mvvproject/DivGMX/divgmx_sound/readme.txt

Sound
Конфигурация высокопроизводительной звуковой карты для spectrum-совместимых компьютеров с шиной ZX-BUS.

После подключения станут доступны такие устройства как:
1. Beeper (стандартный аудио выход)
2. General Sound 512К
3. SounDrive v1.05
4. Turbo Sound - 2x YM2149
5. Tutbo Sound Easy - 2x YM2149 + SAA1099 (12 стерео каналов)
6. Видео-страницы 5 и 7 (порт 7FFD) выводятся на HDMI 640x480@60Hz
