mvvproject/DivGMX/divgmx_spec256/readme.md

#### SPEC256
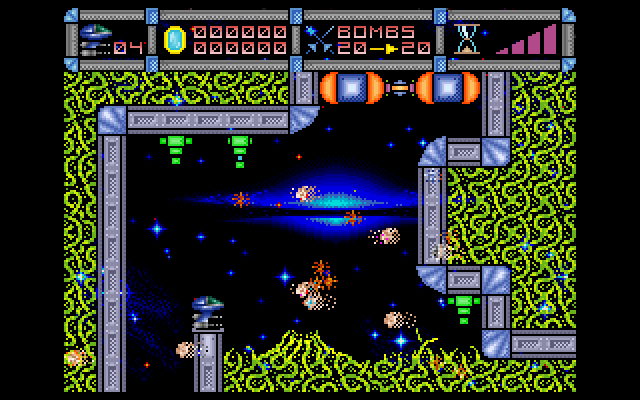
[picture p2: divgmx_spec256/pic1.png]
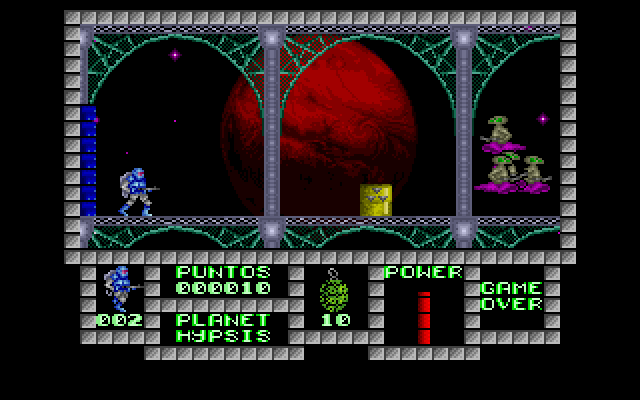
[picture p3: divgmx_spec256/pic2.png]
 

SPEC256: http://www.emulatronia.com/emusdaqui/spec256/download-eng.htm

игры: http://www.emulatronia.com/emusdaqui/spec256/download-eng.htm

редактор: http://kolmck.ru/apps/EmuZ/EmuZWin_Eng.htm

Демонстрационное видео:

Spec256 on FPGA (ReVerSE-U16) (http://www.youtube.com/watch?feature=player_embedded&v=0wNCMqNwaIU)

ReVerSE-U16 FPGA SoftCore - Spec256 (build 20170604) (https://www.youtube.com/watch?v=5JCH4aDUbvE)

build 20171030:
- Реализован фон F6 = Layer on/off

build 20171028:
- CPU: T80_GFX @ 3.5MHz
- RAM: 48K
- ROM: 16K ('82)
- VGA: 256x192 GFX256/Std (ZX Spectrum 48K)
- HDMI: 576P @ 49Hz
- Sound: Port 0xFE (Beeper)
- F1 Joystick on/off
- F2 = режим 256c
- F5 = MENU для загрузки игр
- Joystick: Kempston, Gamepad (Defender Game Master G2)
- Games: Abu Simbel, Army Moves, Army Moves 2, Cybernoid, Game Over, Game Over 2, JetPac, Knight Lore, Phantis, Sabre Wulf, Scooby Doo, Solomon's Key, Underwurlde
