mvvproject/DivGMX/divgmx_board/images/box.jpg

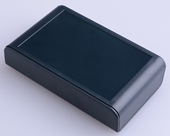
divgmx_board/images/box.jpg
