mvvproject/DivGMX/divgmx_board/images/connectors.jpg

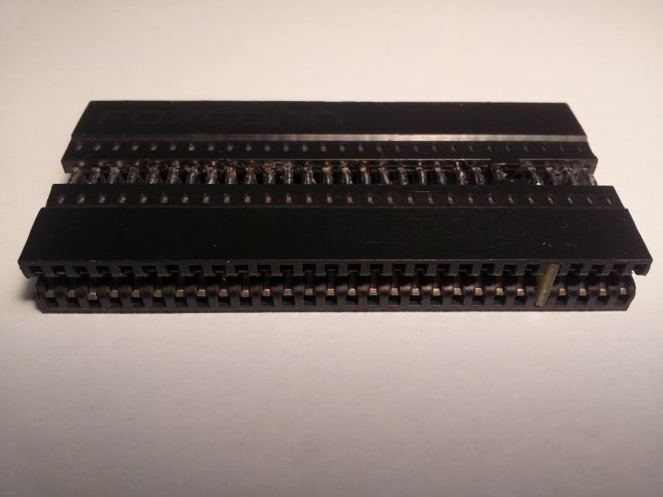
divgmx_board/images/connectors.jpg
