mvvproject/DivGMX/divgmx_board/images/divgmx_brd_eagle.png

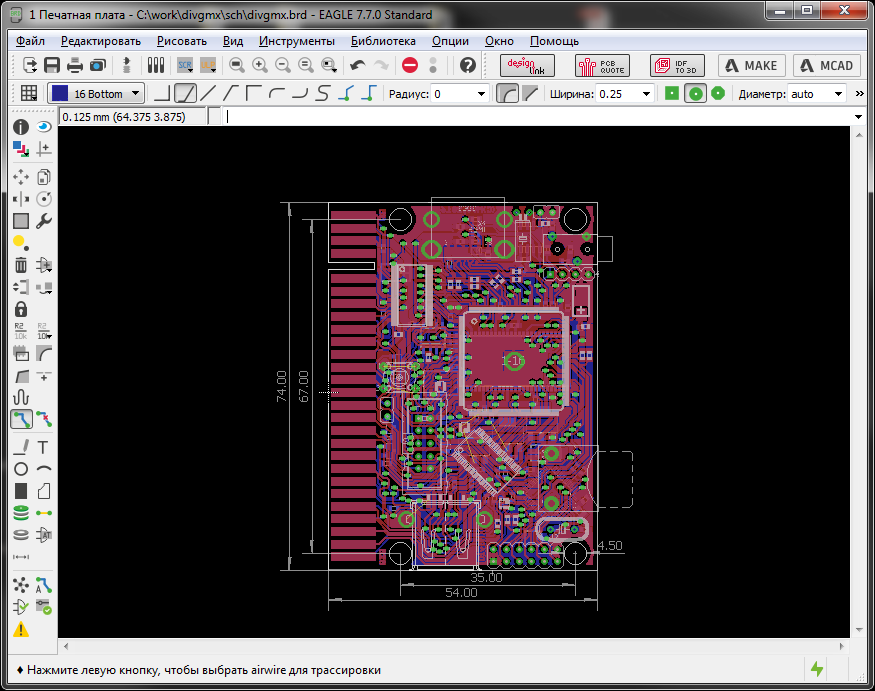
divgmx_board/images/divgmx_brd_eagle.png
