mvvproject/DivGMX/divgmx_board/images/divgmx_spectrum48k.jpg

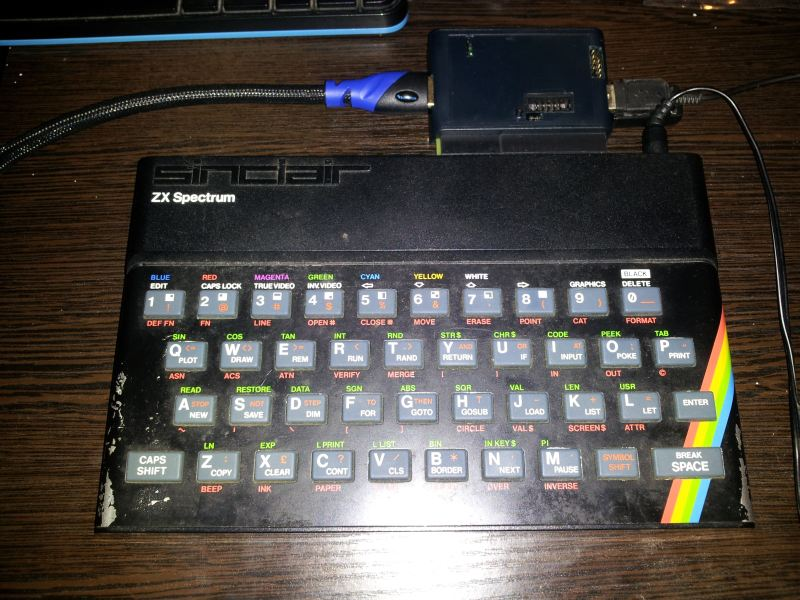
divgmx_board/images/divgmx_spectrum48k.jpg
