mvvproject/DivGMX/divgmx_board/images/divgmx_zx_spectrum+3.jpg

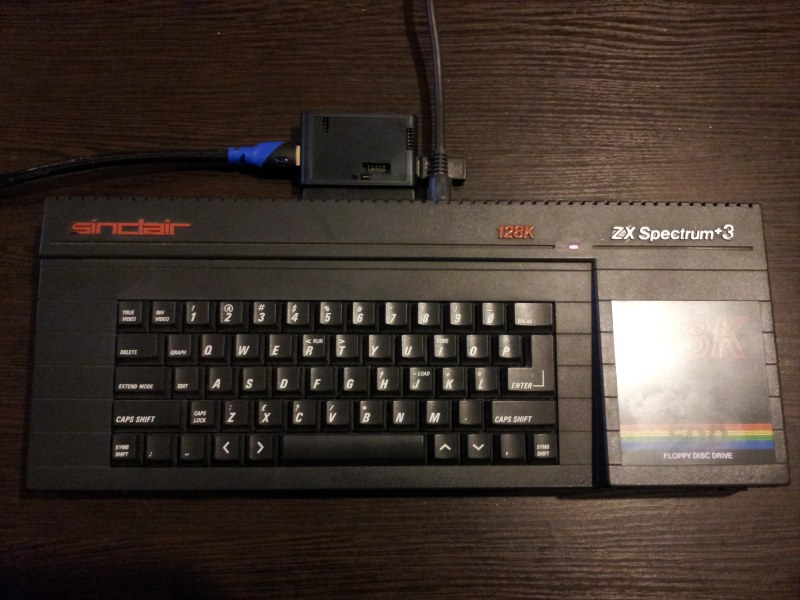
divgmx_board/images/divgmx_zx_spectrum+3.jpg
