mvvproject/DivGMX/divgmx_test_board/readme.txt

HDT (Hardware Diagnostic Tests)
Тест платы DivGMX

Для теста интерфейса, подключите Extender Tester к плате DivGMX, нажимая на кнопку "NMI" на плате DivGMX наблюдайте аналогичное включение светодиодов как в поле Extender.

20170907:
добавлены тесты 05h-29h бегущая единица

20170917:
тесты SDRAM патернами AAh, 55h, 00h, FFh
