mvvproject/DivGMX/divgmx_board/images/divgmx_pxoenix_test.jpg

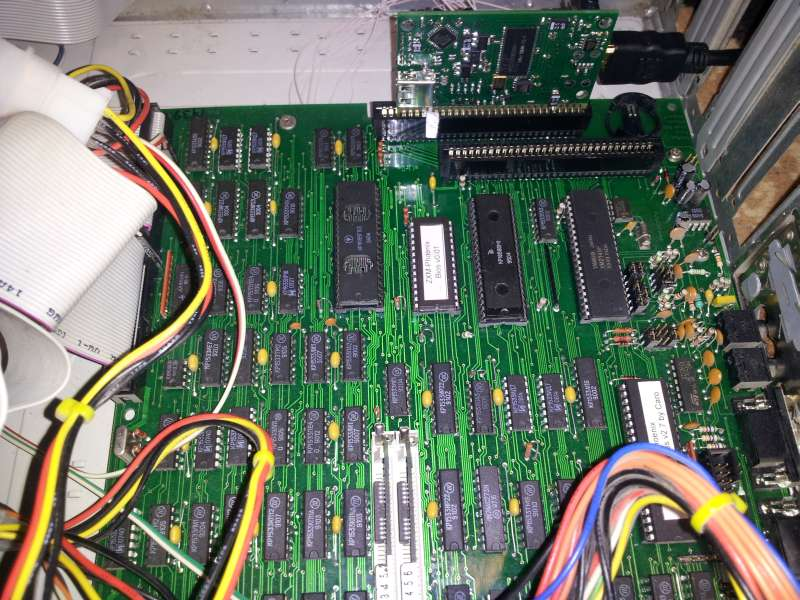
divgmx_board/images/divgmx_pxoenix_test.jpg
