mvvproject/DivGMX/divgmx_test_board/divgmx_extender_tester/DivGMX_extender_tester.jpg

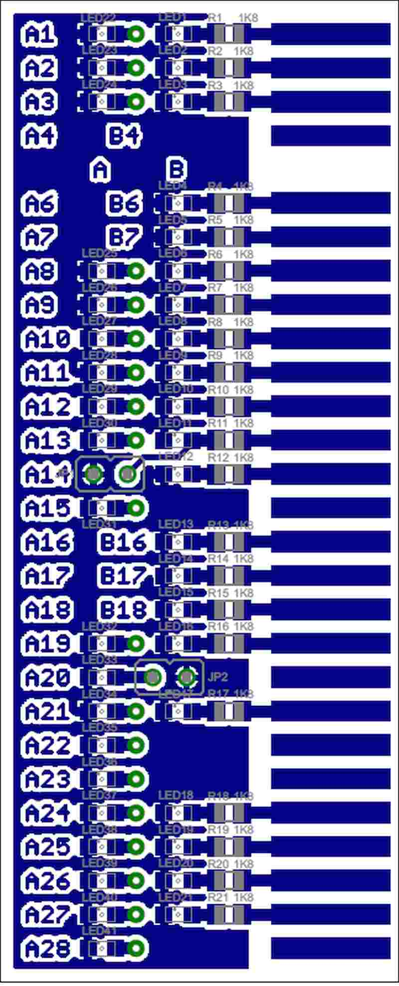
divgmx_test_board/divgmx_extender_tester/DivGMX_extender_tester.jpg
