mvvproject/DivGMX/(threads)

Thread 1 (2020-03-28):

Any boards for sale?

gazsp, 2020-03-28:
Hi there. Are you offering to sell fully assembled boards? Can I email you for more details?

Cheers,
Gaz.

semack, 2020-06-03:
Hi,

The same question, especially in Ukraine ;)

BR,
Andriy.

Thread 2 (2020-06-03):

Harlequin 128 2D question

semack, 2020-06-03:
Доброго здоровья,

Был ли опыт использования с Harlequin 128 2D?
Есть ли возможность приобрести плату?

Я так понял Вы в Черкассах, я из Кременчуга.

С уважением,
Андрей.
