mvvproject/DivGMX/divgmx_test_board/divgmx_extender_tester/divgmx_extender_tester.pdf

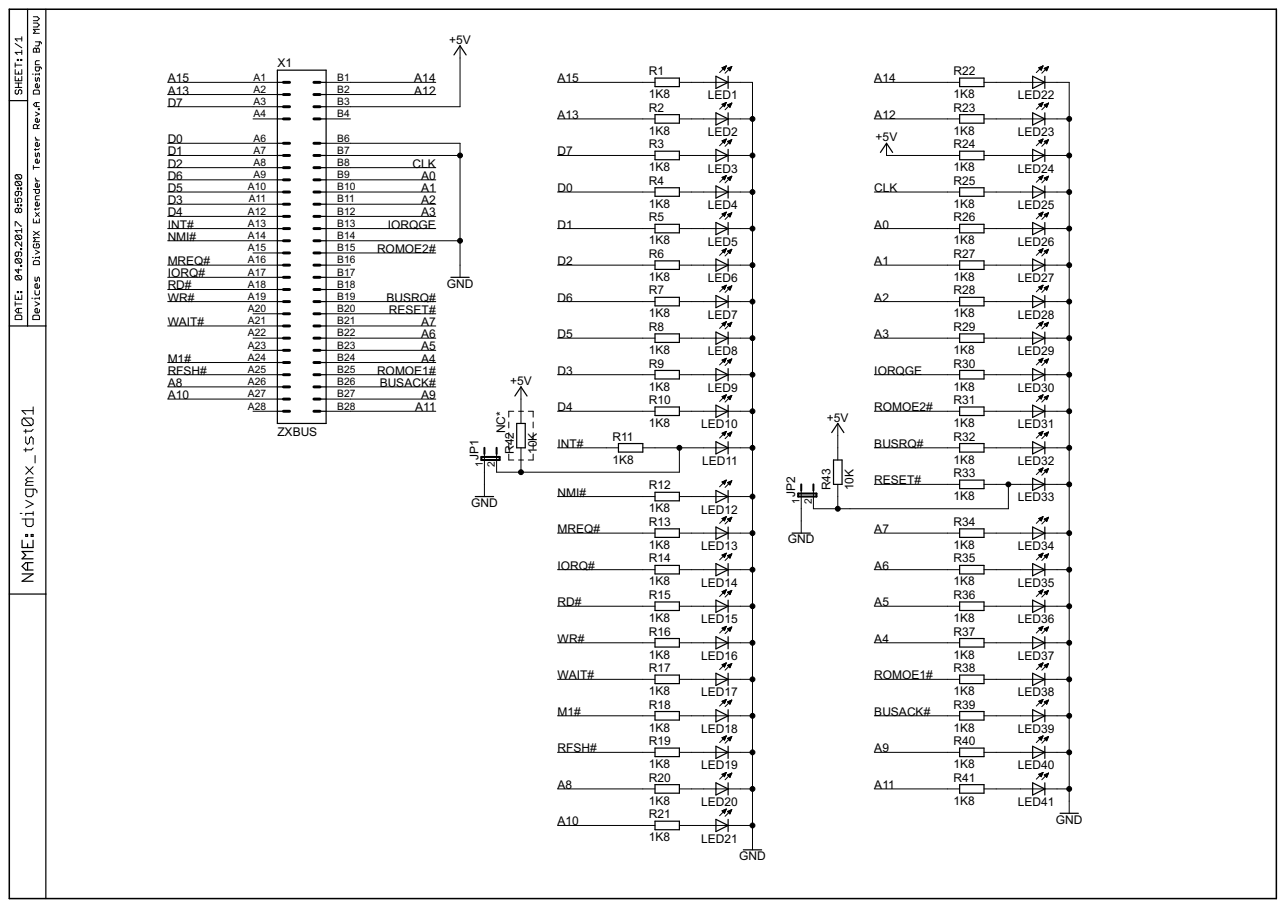
[picture p15: page 1]

NC* ZXBUS 1K8 1K8 GND GND +5V 1K8 1K8 1K8 +5V 1K8 1K8 1K8 1K8 1K8 1K8 1K8 1K8 1K8 1K8 1K8 1K8 1K8 1K8 1K8 1K8 1K8 1K8 GND 1K8 1K8 1K8 1K8 1K8 1K8 1K8 1K8 1K8 1K8 1K8 1K8 1K8 1K8 1K8 1K8 1K8 1K8 10K GND +5V 10K GND +5V A1A2A3A4 A28A6A7A8A9 A10 A11 A12 A13 A14 A15 A16 A17 A18 A19 A20 A21 A22 A23 A24 A25 A26 A27 B1B2B3B4B28 B6B7B8B9B10 B11 B12 B13 B14 B15 B16 B17 B18 B19 B20 B21 B22 B23 B24 B25 B26 B27 X1 R1 LED1 R2 LED2 R3R4 LED3 LED4 R5 LED5 R6 LED6 R7 LED7 R8 LED8 R9R10 LED9 LED10 R11 R12 R13 R14 R15 R16 R17 R18 R19 R20 R21 LED11 LED12 LED13 LED14 LED15 LED16 LED17 LED18 LED19 LED20 LED21 R22 LED22 R23 LED23 R24 R25 LED24 LED25 R26 LED26 R27 LED27 R28 LED28 R29 LED29 R30 R31 LED30 LED31 R32 R33 R34 R35 R36 R37 R38 R39 R40 R41 LED32 LED33 LED34 LED35 LED36 LED37 LED38 LED39 LED40 LED41 R42 R43 JP1 12 JP2 12 A15 A15 A13 A13 D2 D2 D6 D6 D5 D5 D3 D3 D4 D4 INT# INT# NMI# NMI# MREQ# MREQ# IORQ# IORQ# RD# RD# WR# WR# WAIT# WAIT# M1# M1# RFSH# RFSH# A8 A8 A10 A10 D7 D7 D0 D0 D1 D1 A14 A14 A12 A12 CLK CLK A0 A0 A1 A1 A2 A2 A3 A3 IORQGE IORQGE ROMOE2# ROMOE2# BUSRQ# BUSRQ# RESET# RESET# A7 A7 A6 A6 A5 A5 A4 A4 ROMOE1# ROMOE1# BUSACK# BUSACK# A9 A9 A11 A11

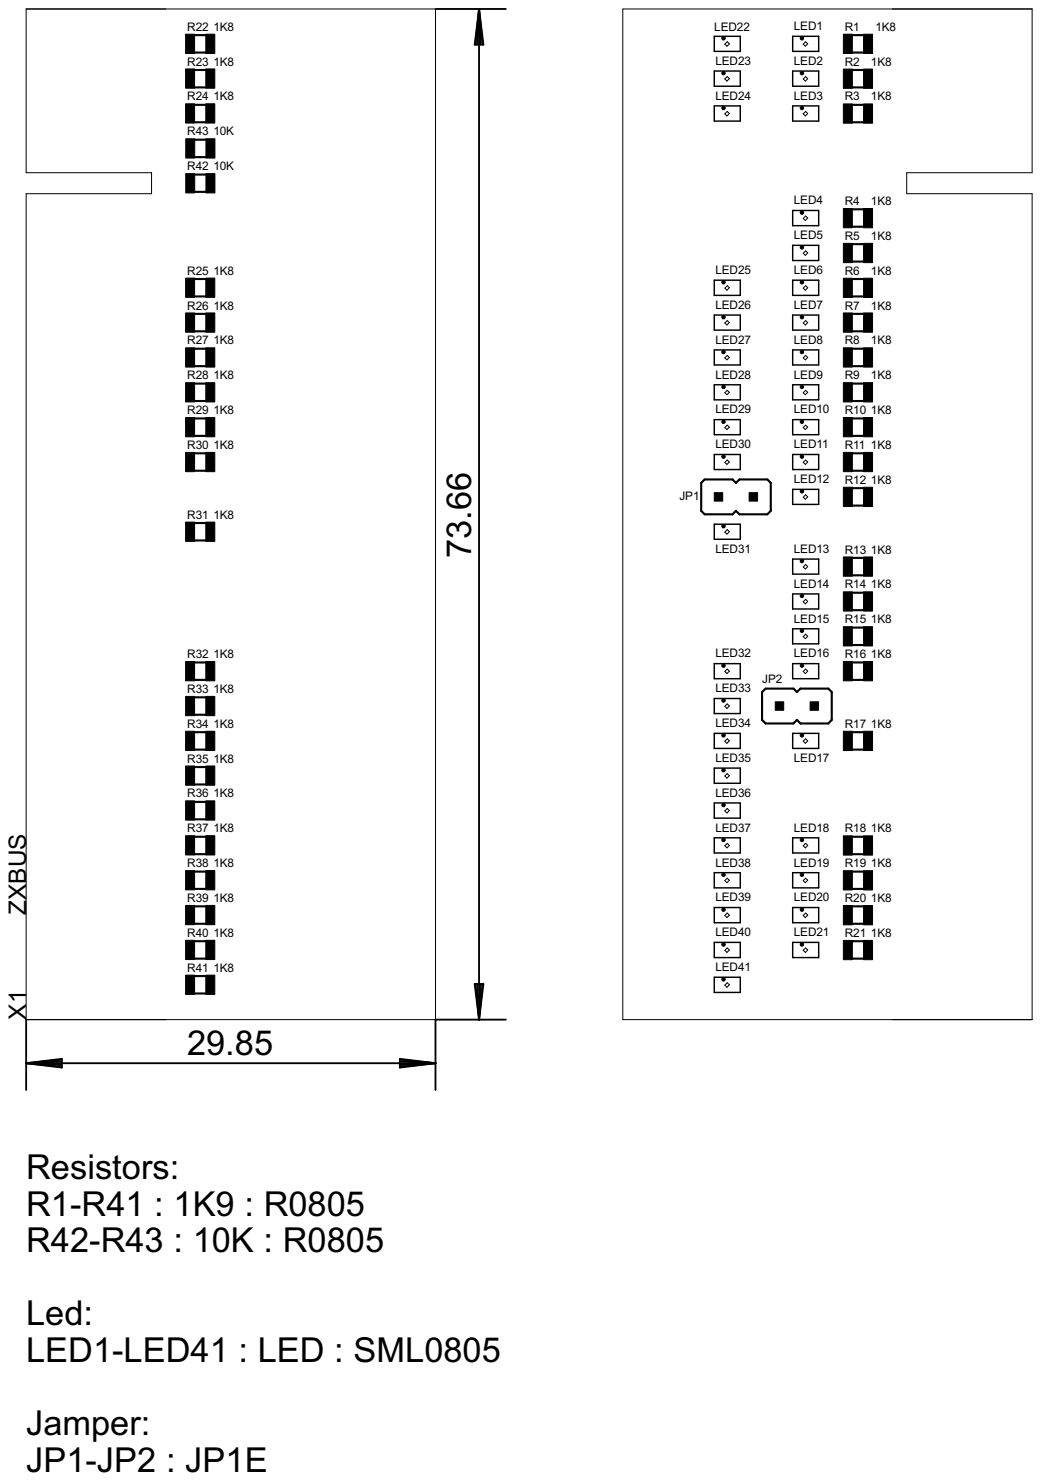
[picture p16: page 2]
