mvvproject/DivGMX/divgmx_tsconf/rtl/ts/memory/dma.v

// This module serves direct DRAM-to-device data transfer

// to do
// - probably add the extra 8 bit counter for number of bursts

module dma (

// clocks
	input wire clk,
	input wire c2,
	input wire reset,

// interface
	input  wire [8:0] dmaport_wr,
	output wire dma_act,
	output reg  [15:0] data,
	output wire [ 7:0] wraddr,
	output wire int_start,

// Z80
	input  wire [7:0] zdata,

// DRAM interface
	output wire [20:0] dram_addr,
	input  wire [15:0] dram_rddata,
	output wire [15:0] dram_wrdata,
	output wire	dram_req,
	output reg	dma_z80_lp,
	output wire	dram_rnw,
	input  wire	dram_next,

// SPI interface
	input  wire  [7:0] spi_rddata,
	output wire  [7:0] spi_wrdata,
	output wire		spi_req,
	input  wire		spi_stb,
	input  wire		spi_start,

// IDE interface
	input  wire [15:0] ide_in,
	output wire [15:0] ide_out,
	output wire		ide_req,
	output wire		ide_rnw,
	input  wire		ide_stb,

// CRAM interface
	output wire		cram_we,

// SFILE interface
	output wire		sfile_we,
	//---------------------
	output wire [3:0] TST
);
	
   assign TST[0] = dma_act;
	assign TST[1] = dma_len; 
	assign TST[2] = b_len[7];
	assign TST[3] = b_ctr[7]; 
// mode:
//  0 - device to RAM (read from device)
//  1 - RAM to device (write to device)

	assign wraddr = d_addr[7:0];
	// wire [8:0] dma_wr = dmaport_wr & {9{!dma_act}};	// blocking of DMA regs write strobes while DMA active
	wire [8:0] dma_wr = dmaport_wr;

	wire dma_saddrl = dma_wr[0];
	wire dma_saddrh = dma_wr[1];
	wire dma_saddrx = dma_wr[2];
	wire dma_daddrl = dma_wr[3];
	wire dma_daddrh = dma_wr[4];
	wire dma_daddrx = dma_wr[5];
	wire dma_len	 = dma_wr[6];
	wire dma_launch = dma_wr[7];
	wire dma_num	 = dma_wr[8];

// DRAM
	assign dram_addr = state_rd ? ((!dv_blt || !phase_blt) ? s_addr : d_addr) : d_addr;
	assign dram_wrdata = data;
	assign dram_req = dma_act && state_mem;
	assign dram_rnw = state_rd;

// devices
	wire [3:0] devsel = {dma_wnr, device};
	wire dv_ram = (device == 3'b001) || (devsel == 4'b0100);
	wire dv_blt = (devsel == 4'b1001);
	wire dv_fil = (devsel == 4'b0100);
	wire dv_spi = (device == 3'b010);
	wire dv_ide = (device == 3'b011);
	wire dv_crm = (devsel == 4'b1100);
	wire dv_sfl = (devsel == 4'b1101);

	wire dev_req = dma_act && state_dev;
	wire dev_stb = cram_we || sfile_we || ide_int_stb || (spi_int_stb && bsel);

	wire spi_int_stb = dv_spi && spi_stb;
	wire spi_int_start = dv_spi && spi_start;
	wire ide_int_stb = dv_ide && ide_stb;
	assign cram_we = dev_req && dv_crm && state_wr;
	assign sfile_we = dev_req && dv_sfl && state_wr;

	// SPI
	assign spi_wrdata = {8{state_rd}} | (bsel ? data[15:8] : data[7:0]);	// send FF on read cycles
	assign spi_req = dev_req && dv_spi;

	// IDE
	assign ide_out = data;
	assign ide_req = dev_req && dv_ide;
	assign ide_rnw = state_rd;
	
	// blitter
	wire [15:0] blt_rddata = {blt_data_h, blt_data_l};
	wire [7:0]  blt_data_h = dma_asz ? blt_data32 : {blt_data3, blt_data2};
	wire [7:0]  blt_data_l = dma_asz ? blt_data10 : {blt_data1, blt_data0};
	wire [7:0]  blt_data32 = |data[15:8]  ? data[15:8]  : dram_rddata[15:8];
	wire [7:0]  blt_data10 = |data[7:0]   ? data[7:0]   : dram_rddata[7:0];
	wire [3:0]  blt_data3  = |data[15:12] ? data[15:12] : dram_rddata[15:12];
	wire [3:0]  blt_data2  = |data[11:8]  ? data[11:8]  : dram_rddata[11:8];
	wire [3:0]  blt_data1  = |data[7:4]   ? data[7:4]   : dram_rddata[7:4];
	wire [3:0]  blt_data0  = |data[3:0]   ? data[3:0]   : dram_rddata[3:0];

// data aquiring
	always @(posedge clk)
		if (state_rd)
		begin
			if (dram_next)
				data <= (dv_blt && phase_blt) ? blt_rddata : dram_rddata;

			if (ide_int_stb)
				data <= ide_in;

			if (spi_int_start)			// data that is already read from SPI, just get it
			begin
				if (bsel)
					data[15:8] <= spi_rddata;
				else
					data[7:0] <= spi_rddata;
			end
		end

// states
	wire state_rd = ~phase;
	wire state_wr = phase;
	wire state_dev = !dv_ram && (dma_wnr ^ !phase);
	wire state_mem = dv_ram || (dma_wnr ^ phase);
		
// states processing
	wire phase_end = phase_end_ram || phase_end_dev;
	wire phase_end_ram = state_mem && dram_next && !blt_hook;
	wire phase_end_dev = state_dev && dev_stb;
	wire blt_hook = dv_blt && !phase_blt && !phase;
	wire fil_hook = dv_fil && phase;
	wire phase_blt_end = state_mem && dram_next && !phase;

	// blitter cycles:
	//	phase	phase_blt	blt_hook	activity
	//	0		0			1			read src
	//	0		1			0			read dst
	//	1		1			0			write dst
	
	reg [2:0] device;
	reg dma_wnr;			// 0 - device to RAM / 1 - RAM to device
	reg dma_salgn;
	reg dma_dalgn;
	reg dma_asz;
	reg phase;				// 0 - read / 1 - write
	reg phase_blt;			// 0 - source / 1 - destination
	reg bsel;				// 0 - lsb / 1 - msb

	always @(posedge clk)
	if (dma_launch)			// write to DMACtrl - launch of DMA burst
	begin
		dma_wnr <= zdata[7];
		dma_z80_lp <= zdata[6];
		dma_salgn <= zdata[5];
		dma_dalgn <= zdata[4];
		dma_asz <= zdata[3];
		device <= zdata[2:0];
		phase <= 1'b0;
		phase_blt <= 1'b0;
		bsel <= 1'b0;
	end

	else
	begin
		if (phase_end && !fil_hook)
			phase <= ~phase;
		if (phase_blt_end)
			phase_blt <= ~phase_blt;
		if (spi_int_stb)
			bsel <= ~bsel;
	end


// counter processing
	reg [7:0] b_len;		// length of burst
	reg [7:0] b_num;		// number of bursts
	reg [7:0] b_ctr;		// counter for cycles in burst
	reg [8:0] n_ctr;		// counter for bursts

	assign dma_act = ~n_ctr[8];
	wire [7:0] b_ctr_next = next_burst ? b_len : b_ctr_dec[7:0];
	wire [8:0] b_ctr_dec = {1'b0, b_ctr[7:0]} - 9'b1;
	wire [8:0] n_ctr_dec = n_ctr - next_burst;
	wire next_burst = b_ctr_dec[8];

	always @(posedge clk)
	if (reset)
		n_ctr[8] <= 1'b1;	   // disable DMA on RESET

	else
		if (dma_launch)			// launch of DMA burst
		begin
			b_ctr <= b_len;
			n_ctr <= {1'b0, b_num};
		end

		else if (phase && phase_end)		// cycle processed
		begin
			b_ctr <= b_ctr_next;
			n_ctr <= n_ctr_dec;
		end


// loading of burst parameters
	always @(posedge clk)
	begin
		if (dma_len)
			b_len <= zdata;

		if (dma_num)
			b_num <= zdata;
	end


// address processing

	// source
	wire [20:0] s_addr_next = {s_addr_next_h[13:1], s_addr_next_m, s_addr_next_l[6:0]};
	wire [13:0] s_addr_next_h = s_addr[20:7] + s_addr_add_h;
	wire [1:0] s_addr_add_h = dma_salgn ? {next_burst && dma_asz, next_burst && !dma_asz} : {s_addr_inc_l[8], 1'b0};
	wire s_addr_next_m = dma_salgn ? (dma_asz ? s_addr_next_l[7] : s_addr_next_h[0]) : s_addr_inc_l[7];
	wire [7:0] s_addr_next_l = (dma_salgn && next_burst) ? s_addr_r : s_addr_inc_l[7:0];
	wire [8:0] s_addr_inc_l = {1'b0, s_addr[7:0]} + 9'b1;

	reg [20:0] s_addr;	  // current source address
	reg [7:0] s_addr_r;	 // source lower address

	always @(posedge clk)
		if ((dram_next || dev_stb) && state_rd && (!dv_blt || !phase_blt))			// increment RAM source addr
			s_addr <= s_addr_next;

		else
		begin
			if (dma_saddrl)
			begin
				s_addr[6:0] <= zdata[7:1];
				s_addr_r[6:0] <= zdata[7:1];
			end

			if (dma_saddrh)
			begin
				s_addr[12:7] <= zdata[5:0];
				s_addr_r[7] <= zdata[0];
			end

			if (dma_saddrx)
				s_addr[20:13] <= zdata;
		end

	// destination
	wire [20:0] d_addr_next = {d_addr_next_h[13:1], d_addr_next_m, d_addr_next_l[6:0]};
	wire [13:0] d_addr_next_h = d_addr[20:7] + d_addr_add_h;
	wire [1:0] d_addr_add_h = dma_dalgn ? {next_burst && dma_asz, next_burst && !dma_asz} : {d_addr_inc_l[8], 1'b0};
	wire d_addr_next_m = dma_dalgn ? (dma_asz ? d_addr_next_l[7] : d_addr_next_h[0]) : d_addr_inc_l[7];
	wire [7:0] d_addr_next_l = (dma_dalgn && next_burst) ? d_addr_r : d_addr_inc_l[7:0];
	wire [8:0] d_addr_inc_l = {1'b0, d_addr[7:0]} + 9'b1;

	reg [20:0] d_addr;	  // current dest address
	reg [7:0] d_addr_r;	 // dest lower address

	always @(posedge clk)
		if ((dram_next || dev_stb) && state_wr)			// increment RAM dest addr
			d_addr <= d_addr_next;
		else
		begin
			if (dma_daddrl)
			begin
				d_addr[6:0] <= zdata[7:1];
				d_addr_r[6:0] <= zdata[7:1];
			end

			if (dma_daddrh)
			begin
				d_addr[12:7] <= zdata[5:0];
				d_addr_r[7] <= zdata[0];
			end

			if (dma_daddrx)
				d_addr[20:13] <= zdata;
		end

	// INT generation
	reg dma_act_r;
	always @(posedge clk)
		dma_act_r <= dma_act;

	assign int_start = !dma_act && dma_act_r;
	
endmodule
