mvvproject/DivGMX/divgmx_tsconf/rtl/ts/cpu/zclock.v

// PentEvo project (c) NedoPC 2008-2011
//
// Z80 clocking module, also contains some wait-stating when 14MHz
//
// IDEAL:
// clk    _/`\_/`\_/`\_/`\_/`\_/`\_/`\_/`\_/`\_/`\_/`\_/`\_/`\_/`\_/`\_/`\_/`\_/`\_/`\_/`\_/`\_/`\_/`\_/`\_/`\_/`\_/`\_/`\_/`\_/`\_/`\
//          |   |   |   |   |   |   |   |   |   |   |   |   |   |   |   |   |   |   |   |   |   |   |   |   |   |   |   |   |   |   |
// zclk     /```\___/```\___/```\___/```````\_______/```````\_______/```````````````\_______________/```````````````\_______________/`
//          |   |   |   |   |   |   |   |   |   |   |   |   |   |   |   |   |   |   |   |   |   |   |   |   |   |   |   |   |   |   |
// zpos     `\___/```\___/```\___/```\___________/```\___________/```\___________________________/```\___________________________/```\
//          |   |   |   |   |   |   |   |   |   |   |   |   |   |   |   |   |   |   |   |   |   |   |   |   |   |   |   |   |   |   |
// zneg     _/```\___/```\___/```\_______/```\___________/```\___________________/```\___________________________/```\________________

// clock phasing:
// c3 must be zpos for 7mhz, therefore c1 - zneg
// for 3.5 mhz, c3 is both zpos and zneg (alternating)


// 14MHz rulez:
// 1. do variable stalls for memory access.
// 2. do fallback on 7mhz for external IO accesses
// 3. clock switch 14-7-3.5 only at RFSH

module zclock(

	input clk,
	//output reg zclk_out, // generated Z80 clock - passed through inverter externally!
	output wire zclk_out,
	input c1, c3, c14Mhz,     

	input  wire iorq_s,
	input  wire external_port,

	output reg zpos,
	output reg zneg,
	output wire dos_stall_o,

// stall enables and triggers
	input  wire cpu_stall,
	input  wire ide_stall,
	input  wire dos_on,
	input  wire vdos_off,

	input [1:0] turbo  // 2'b00 -  3.5 MHz
	                   // 2'b01 -  7.0 MHz
	                   // 2'b1x - 14.0 MHz
);
	reg zclk_o;
   assign zclk_out = ~zclk_o;
   assign dos_stall_o = !stall_count_end || dos_on;
	//`ifdef SIMULATE
//	initial // simulation...
//	begin
//		c2_cnt = 1'b0;
//		turbo   = 2'b00;
//		old_rfsh_n  = 1'b1;
//		clk14_src   = 1'b0;
//
//		zclk_out = 1'b0;
//	end
//`endif

   


// wait generator
   wire dos_io_stall = stall_start || !stall_count_end;
   wire stall_start = dos_stall || io_stall;
   wire dos_stall = dos_on || vdos_off; 
   wire io_stall = iorq_s && external_port && turbo[1]; //- NOT WORK
	wire stall_count_end = stall_count[3];

	reg [3:0] stall_count;
	always @(posedge clk)
		if (stall_start)
		begin
			if (dos_stall)
				stall_count <= 4'd4;	// 4 tacts 28MHz (1 tact 7MHz)
			else if (io_stall)
				stall_count <= 4'd0;	// 8 tacts 28MHz (1 tact 3.5MHz)
		end
		else if (!stall_count_end)
			stall_count <= stall_count + 3'd1; 		


// Z80 clocking pre-strobes
	wire pre_zpos = turbo[1] ? pre_zpos_140 : ( turbo[0] ? pre_zpos_70 : pre_zpos_35 );
	wire pre_zneg = turbo[1] ? pre_zneg_140 : ( turbo[0] ? pre_zneg_70 : pre_zneg_35 );

	reg clk14_src;	// source for 14MHz clock
	always @(posedge clk)
	if (!stall && !(c14Mhz == 1'b1 && !clk14_src)) // c14Mhz =c1
	//if (!stall) 	
		clk14_src <= ~clk14_src;

	wire pre_zpos_140 = clk14_src;
	wire pre_zneg_140 = ~clk14_src;

	wire pre_zpos_70 = c1;
	wire pre_zneg_70 = c3;

	wire pre_zpos_35 = c1_cnt && c1;
	wire pre_zneg_35 = !c1_cnt && c1;

	reg c1_cnt;
	always @(posedge clk) if (c1)
		c1_cnt <= ~c1_cnt;

		
// Z80 clocking strobes
//---------------INPUT----count generator-     NO
	wire stall = cpu_stall || dos_io_stall || ide_stall;

	always @(posedge clk)
	begin
		zpos <= !stall && pre_zpos && zclk_o;
		zneg <= !stall && pre_zneg && !zclk_o;
	end

	
	// make Z80 clock: account for external inversion and make some leading of clock
	// 9.5 ns propagation delay: from clk posedge to zclk returned back any edge
	// (1/28)/2=17.9ns half a clock lead
	// 2.6ns lag because of non-output register emitting of zclk_out
	// total: 5.8 ns lead of any edge of zclk relative to posedge of clk => ACCOUNT FOR THIS WHEN DOING INTER-CLOCK DATA TRANSFERS

	// Z80 clocking
	always @(negedge clk)
	begin
		if (zpos)
			zclk_o <= 1'b0;

		if (zneg)
			zclk_o <= 1'b1;
	end


endmodule
