mvvproject/DivGMX/divgmx_alf/rtl/video/sync.vhd

-------------------------------------------------------------------[24.06.2017]
-- Sync
-------------------------------------------------------------------------------
-- Engineer: MVV <mvvproject@gmail.com>

library ieee;
use ieee.std_logic_1164.all;
use ieee.std_logic_unsigned.all;
use IEEE.STD_LOGIC_ARITH.all;

entity sync is port (
	I_CLK		: in std_logic; 			-- VGA dot clock
	I_EN		: in std_logic;
	O_H		: out std_logic_vector(9 downto 0);
	O_HCNT		: out std_logic_vector(9 downto 0);
	O_VCNT		: out std_logic_vector(9 downto 0);
	O_INT		: out std_logic;
	O_FLASH		: out std_logic;			-- частота мерцания курсора
	O_BLANK		: out std_logic;
	O_HSYNC		: out std_logic;			-- horizontal (line) sync
	O_VSYNC		: out std_logic);			-- vertical (frame) sync
end entity;

architecture rtl of sync is

-- ModeLine "640x480@60Hz"  25,175 640 656 752 800 480 490 492 525 -HSync -VSync
	-- Horizontal Timing constants  
	constant h_pixels_across	: integer := 640 - 1;
	constant h_sync_on		: integer := 656 - 1;
	constant h_sync_off		: integer := 752 - 1;
	constant h_end_count		: integer := 800 - 1;
	-- Vertical Timing constants
	constant v_pixels_down		: integer := 480 - 1;
	constant v_sync_on		: integer := 490 - 1;
	constant v_sync_off		: integer := 492 - 1;
	constant v_end_count		: integer := 525 - 1;

	signal h			: std_logic_vector(9 downto 0) := "0000000000"; 	-- horizontal pixel counter
	signal hcnt			: std_logic_vector(9 downto 0) := "0000000000"; 	-- horizontal pixel counter
	signal vcnt			: std_logic_vector(9 downto 0) := "0000000000"; 	-- vertical line counter
	signal hsync			: std_logic;
	signal vsync			: std_logic;
	signal blank			: std_logic;
	signal int			: std_logic;
	signal counter			: std_logic_vector(5 downto 0);
	
begin
		
	process (I_CLK, I_EN, hcnt, int)
	begin
		if I_CLK'event and I_CLK = '1' then
			if I_EN = '1' then
				if h = h_end_count then
					h <= (others => '0');
				else
					h <= h + 1;
				end if;
				
				if h = 4 then
					hcnt <= (others => '0');
				else
					hcnt <= hcnt + 1;
				end if;
				

				if hcnt = h_sync_on then
					if vcnt = v_end_count then
						vcnt <= (others => '0');
					else
						vcnt <= vcnt + 1;
					end if;
				end if;
				
				if int = '1' then
					counter <= counter + 1;
				end if;
			end if;
		end if;
	end process;

	hsync	<= '1' when (hcnt <= h_sync_on) or (hcnt > h_sync_off) else '0';
	vsync	<= '1' when (vcnt <= v_sync_on) or (vcnt > v_sync_off) else '0';
	blank	<= '1' when (hcnt > h_pixels_across) or (vcnt > v_pixels_down) else '0';
	int	<= '1' when (hcnt = h_sync_on and vcnt = v_sync_on) else '0';

	O_H	<= h;
	O_HCNT	<= hcnt;
	O_VCNT	<= vcnt;
	O_INT	<= int;
	O_FLASH	<= counter(5);
	O_HSYNC <= hsync;
	O_BLANK <= blank;
	O_VSYNC	<= vsync;

end architecture;
