mvvproject/DivGMX/divgmx_rk86/rtl/keyboard/receiver.vhd

-------------------------------------------------------------------[27.02.2016]
-- Receiver
-------------------------------------------------------------------------------
-- Engineer: 	MVV

library ieee;
use ieee.std_logic_1164.all;

entity receiver is
	generic (
		divisor		: integer := 434 );	-- divisor = 50MHz / 115200 Baud = 434
	port (
		I_CLK		: in  std_logic;
		I_RESET		: in  std_logic;
		I_RX		: in  std_logic;
		O_DATA		: out std_logic_vector(7 downto 0);
		O_READY		: out std_logic);
end receiver;

architecture rtl of receiver is
	constant halfbit 	: integer := divisor / 2; 
	signal rx_buffer	: std_logic_vector(7 downto 0);
	signal rx_bit_count	: integer range 0 to 10;
	signal rx_count		: integer range 0 to divisor;
	signal rx_avail		: std_logic;
	signal rx_shift_reg	: std_logic_vector(7 downto 0);
	signal rx_bit		: std_logic;
	
begin

process(I_CLK, I_RESET) is
begin
	if I_RESET = '1' then
		rx_buffer <= (others => '0');
		rx_bit_count <= 0;
		rx_count <= 0;
		rx_avail <= '0';
	elsif I_CLK'event and I_CLK = '1' then
	-- Receiver
		rx_avail <= '0';
		if rx_count /= 0 then 
			rx_count <= rx_count - 1;
		else
			if rx_bit_count = 0 then		-- wait for startbit
				if rx_bit = '0' then		-- FOUND
					rx_count <= halfbit;
					rx_bit_count <= rx_bit_count + 1;                                               
				end if;
			elsif rx_bit_count = 1 then		-- sample mid of startbit
				if rx_bit = '0' then		-- OK
					rx_count <= divisor;
					rx_bit_count <= rx_bit_count + 1;
					rx_shift_reg <= "00000000";
				else				-- ERROR
					rx_bit_count <= 0;
				end if;
			elsif rx_bit_count = 10 then		-- stopbit
				if rx_bit = '1' then		-- OK
					rx_buffer <= rx_shift_reg;
					rx_avail <= '1';
					rx_count <= 0;
					rx_bit_count <= 0;
				else				-- ERROR
					rx_count <= divisor;
					rx_bit_count <= 0;
				end if;
			else
				rx_shift_reg(6 downto 0) <= rx_shift_reg(7 downto 1);
				rx_shift_reg(7)	<= rx_bit;
				rx_count <= divisor;
				rx_bit_count <= rx_bit_count + 1;
			end if;
		end if;
	end if;
end process;

-- Sync incoming RXD (anti metastable)
syncproc: process (I_RESET, I_CLK) is
begin
	if I_RESET = '1' then
		rx_bit <= '1';
	elsif I_CLK'event and I_CLK = '0' then
		rx_bit <= I_RX;
	end if;
end process;

O_DATA  <= rx_buffer;
O_READY	<= rx_avail;

end rtl;
